Bejaine/Wake-Word-Detection-System-EW2/readme.md

## Wake Word Detection System
MEMS Microphone Pre-Amplifier with Automatic Gain Control (AGC) and Anti-Aliasing Filter for always-on voice wake-word detection in smart home devices. \
The hardware interface is created with all analog devices and the software component is a speech detection ML Model running on an edge device, the Raspberry Pi 4, API calling Gemini Flash for queries. \
[Link for the analog circit demonstration and wakeword demonstration](https://iiithydstudents-my.sharepoint.com/:f:/g/personal/bejaine_birju_students_iiit_ac_in/IgAevIl6izAORrplVr_9wEUuAbm-aCxeJ9gKoqiDplkEUGc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) \
Created as part of a project in the course Electronics Workshop 2 at IIIT Hyderabad.
