Bejaine/Wake-Word-Detection-System-EW2/Presentations/FinalEval-Presentation.pdf

## Electronics Workshop 2 - 2026

Course Project 2

Electronics Workshop 2 - 2026 | 1 / 24

## Team Details

Team - Table 10 Lab Nilgiri 114

Name: Ahamed Adikool Nishan Roll Number: 2024112025

Name: Bejaine Birju
Roll Number: 2024102060

## Project

Create a MEMS microphone preamplifier with automatic gain control (AGC) and anti-aliasing filter for always-on voice wake-word detection in smart home devices.

## Proposed Solution

A low power circuit using a preamplifier circuit along with the MEMS microphone interface, succeeded by an automatic gain control (AGC) stage, a gain circuit, an Anti Aliasing Filter and an Active Band Pass Filter, connected to an ADC and the ESP, interfaced with a Language Model aboard a Raspberry Pi 4 for wake word identification and querying.

## Stages

Stage 1: MEMS Interface
Stage 2: Pre-Amp Stage
Stage 3: Automatic Gain Control Stage 4: Gain Stage
Stage 5: Anti-Aliasing Filter Stage 6: Active Band Pass Filter Stage 7: ADC
Stage 8: ESP32
Stage 9: Raspberry Pi & TinyML model

## Stage 1: MEMS Interface

Component: SPW2430 MEMS Microphone & Breakout Board

Detects acoustic pressure and converts it to an analog voltage signal Small form factor, high sensitivity – ideal for voice recognition Requires 3.3 V DC at Vin; AC-coupled output fed to Pre-Amp Typical maximum output: ≈ 100 mVpp

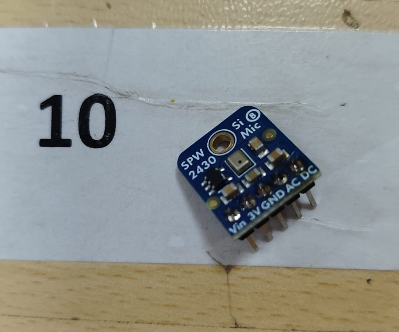
[picture p1: figure]

Figure: SPW2430 MEMS Microphone Module

## Stage 2: Pre-Amplifier – Theory

Topology: Common-Emitter Differential Amplifier (NPN BJT pair)

High input impedance, low output impedance, good noise rejection Amplifies differential signal; rejects common-mode noise (CMRR)

Single Input, Unbalanced Output configuration used

Key gain expressions:

Ad = −

gmRC
2

, Ac = −

αRC
re + 2REE

CMRR = 20 log
Ad
Ac
| ≈ 20 log(gmREE )

Design target: Single-ended differential gain Ad ≈ 10

## Stage 2: Pre-Amplifier – Design

Component values:
RC = 1.5 kΩ (collector load) REE = 3.3 kΩ (tail resistor, −5 V rail)
BJT: BC547B (β = 200)

Operating point:

IC ≈ 0.65 mA, | gm ≈ 26 mA/V
Ad ≈ 19.5, | Ac ≈ 0.23

CMRR ≈ 38.7 dB

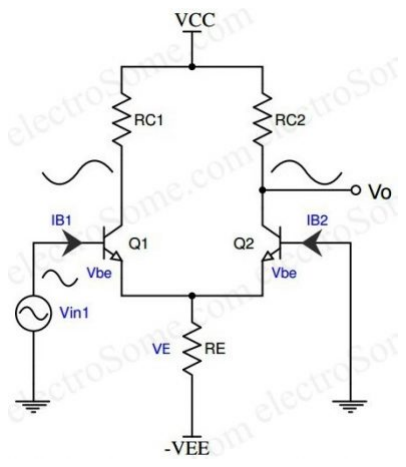
[picture p2: figure]

Figure: Pre-Amp Circuit Diagram

## Stage 3: Automatic Gain Control (AGC)

Components:
BF245B N-Channel JFET – Variable gain element UA741 Op-Amp – Inverting amplifier

BC557C PNP BJT – Envelope detector
R4 = 100 kΩ, R17 = 10 kΩ, C2 = 10 µF, R5 = 156 kΩ

Three functional blocks:
1 | Variable Gain Amplifier – JFET as gate-controlled resistor
2 | Envelope Detector – BC557C tracks signal peak into C2
3 | Control Feedback – VC drives JFET gate (negative feedback)

## AGC Theory: Variable Gain & Feedback

JFET channel resistance (ohmic region):

rDS (VGS ) = | rDS0
1 − VGS /VP

, rDS0 = 250 Ω, VP ≈ −2 V

Inverting amplifier gain:

Av (VGS ) = −

R4

R17 + rDS (VGS )

= −

100 k
10 k + rDS

Range: 0 to ≈ −9.76 (0 to ≈ 19.8 dB)

AGC time constants:

τattack ≪ 1 ms, τrelease = R5 · C2 = 156 kΩ × 10 µF = 1.56 s

Slow release prevents “pumping” artefacts during speech pauses.

Output coupling: fc = 1/(2π · 4.7 k · 1 µ) ≈ 33.9 Hz

## AGC LTspice Simulation Circuit

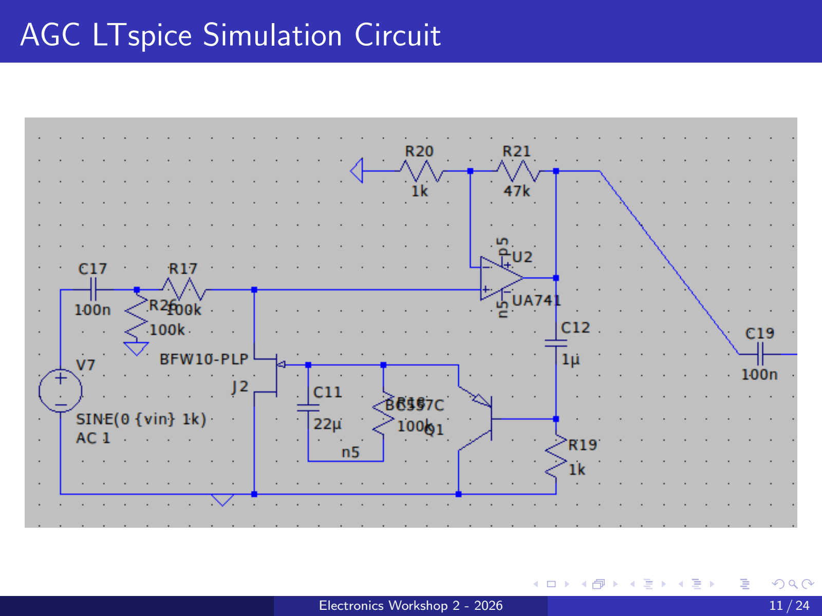
[picture p3: page 11]

## Stage 4: Gain Stage – Theory & Design

Topology: Common-Emitter amplifier with voltage-divider bias and split emitter resistors along with emitter degeneration.
We have designed for a voltage gain of 2.
The voltage gain ]

## Stage 5: Anti-Aliasing Filter (AAF) – Theory

Purpose: Low-pass filter before ADC to prevent aliasing (Nyquist–Shannon theorem)

Topology: 4th-order Butterworth – two cascaded 2nd-order Sallen-Key stages
Maximally flat passband – minimal distortion over voice band Rolloff: −80 dB/decade beyond cutoff
Cutoff set to 10 kHz (half the 20 kHz sampling rate)

Sallen-Key transfer function:

H(s) = | 1
s

2R1R2C1C2 + sC2(R1 + R2) + 1

ωc =

1
√
R1R2C1C2

, Q =

√
R1R2C1C2

C2(R1 + R2)

## AAF LTspice Simulation Circuit

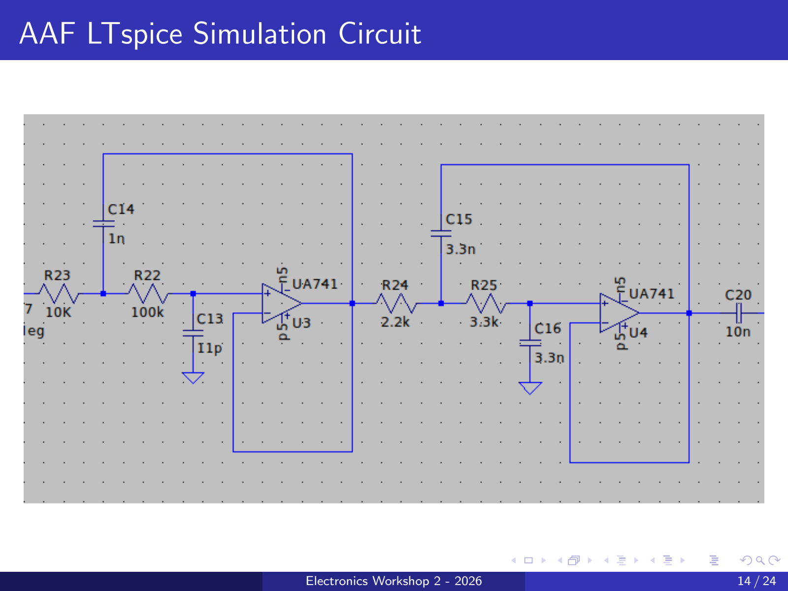
[picture p4: page 14]

## AAF Hardware Circuit

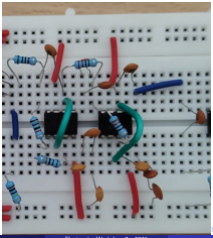
[picture p5: figure]

## Stage 6: Active Band Pass Filter – Theory

Purpose: Provide high-pass filtering (DC blocking) and additional low-pass filtering with amplification in a single stage.

Topology: Passive HPF → Non-inverting Op-Amp → Passive LPF

Overall transfer function:

H(s) =
1 + R4
R3
·

sR1C1
(1 + sR1C1)(1 + sR2C2)

Designed cutoffs:

fHP =

1
2π · 56 k · 47 n

≈ 60.5 Hz

fLP =

1
2π · 10 k · 2 n

≈ 7.96 kHz

Amplifier gain:

Av = 1 + 10 k
10 k = 2

## BPF LTspice Simulation Circuit

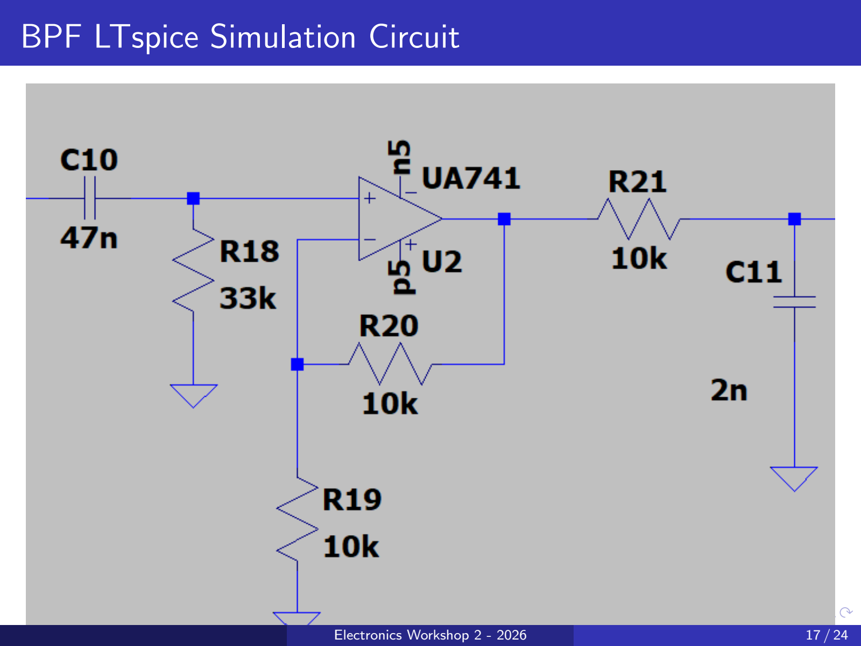
[picture p6: page 17]

## Input Protection: Schottky Diode Clamp (BAT54S)

Purpose: Protect ESP32 ADC from voltages outside 0–3.3 V

Topology: Rail-to-rail clamp (VF ≈ 0.25 V for BAT54S)

Vhigh = 3.3 + 0.25 = 3.55V, Vlow = 0 − 0.25 = −0.25V

Both within the ESP32 absolute maximum of 3.6 V.

In normal operation both diodes are reverse-biased and do not affect the signal. A standard silicon diode (VF ≈ 0.65 V) would clamp at 3.95 V – above the limit.

## Stage 7: Analog-to-Digital Converter (PCM1808)

Component: PCM1808 Stereo ADC (Texas Instruments)

Single-ended analog input, supports sample rates up to 96 kHz Operates in slave mode – I²S master clock provided by ESP32 System clock: 256fS , 384fS , or 512fS (auto-detected)
24-bit audio data, left-justified within 32-bit I²S frame

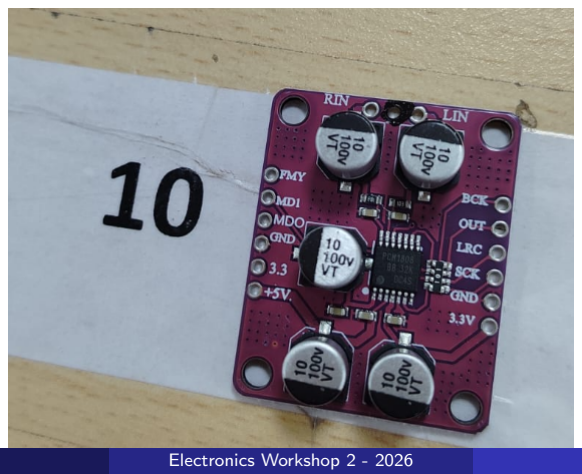
[picture p7: figure]

## Stage 8: ESP32 – I²S Master & Serial Bridge

Role: Drive the PCM1808 ADC and stream audio to Raspberry Pi over UART

I

2S configured at 16 kHz, 32-bit samples, mono (right channel)

APLL enabled for low-jitter master clock on GPIO 3 (MCLK) BCK / LRCK / DATA on GPIOs 26 / 25 / 22
Each 32-bit sample right-shifted by 16 bits → 16-bit PCM Framed UART transmission at 460800 baud: 4-byte sync header: 0xDE 0xAD 0xBE 0xEF
256 bytes audio payload (128 samples × 2 bytes)
8 DMA buffers × 512 bytes to prevent data loss

## Stage 9: Raspberry Pi 4 – Wake Word Detection

Role: Host processor running the full wake-word pipeline

1 | Frame Sync: Scan byte stream for 0xDE 0xAD 0xBE 0xEF header
2 | DSP Chain: 4th-order Butterworth BPF: 80–7500 Hz (SOS, 64-bit float) Linear gain 5×, hard-clipped to 16-bit range
3 | Wake-Word Inference:
| openWakeWord engine, pre-trained Alexa model Input: 1280 samples (80 ms at 16 kHz) Detection threshold: 0.1; debounce: 1.5 s

Final circuit demonstrated wake word detection with decent confidence scores in both noisy and non-noisy environments.

## Amazon Alexa!

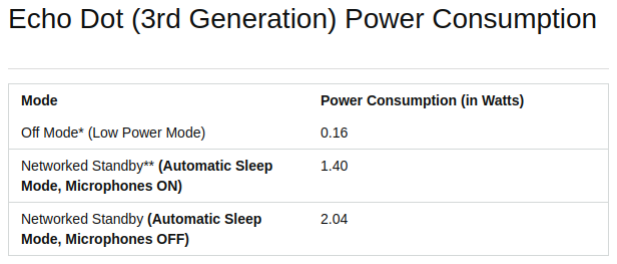
[picture p8: figure]

Figure: Power consumption metrics of the Amazon Alexa/Echo model with voice wake word detection Click here (https://www.amazon.co.uk/gp/help/customer/display.html?nodeId=GWYHKH4C79ZW6QPC)

## Our Alexa!

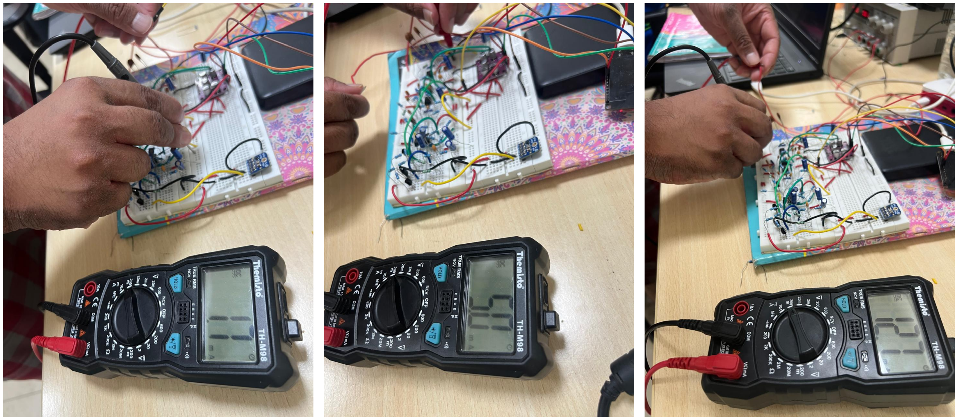
[picture p9: figure]

Figure: Pictures taken while measuring power consumed by our circuit

Ptotal = (3.3 V × 1.7 mA) + (5 V × 12.7 mA) + (5 V × 5 mA)

Ptotal = 5.61 mW + 63.5 mW + 25 mW = 94.11 mW

## Conclusion

Successfully designed and implemented a complete analog front-end for always-on wake word detection
Signal chain: MEMS mic → Pre-Amp → AGC → Gain → AAF → BPF → ADC → ESP32 → Raspberry Pi

AGC maintains constant output across varying speaker distances 4th-order Butterworth AAF provides −80 dB/decade attenuation Total power consumption: 94.11 mW (comparable to commercial devices)

Wake word “Alexa” detected with good confidence in noisy and quiet environments
