Bejaine/Wake-Word-Detection-System-EW2/Presentations/MidEval-Presentation.pdf

## Electronics Workshop 2 - 2026

Course Project 2

Electronics Workshop 2 - 2026 | 1 / 31

## Team Details

Team - Table 10 Lab Nilgiri 114

Name: Ahamed Adikool Nishan Roll Number: 2024112025

Name: Bejaine Birju
Roll Number: 2024102060

## Project

Create a MEMS microphone preamplifier with automatic gain control (AGC) and anti-aliasing filter for always-on voice wake-word detection in smart home devices.

## Proposed Solution

A low power circuit using a preamplifier circuit along with the MEMS microphone interface, succeeded by an automatic gain control (AGC) stage, a gain circuit, an anti-aliasing filter and a Schottky diode clamp for voltage regulation, interfaced with a Language Model for wake word identification.

## Stages

Stage 1: MEMS Interface
Stage 2: Pre-Amp Stage
Stage 3: Automatic Gain Control Stage 4: Gain Stage
Stage 5: Anti-Aliasing Filter Stage 6: Schottky Diode Clamp Stage 7: Large Language Model

## Components Needed

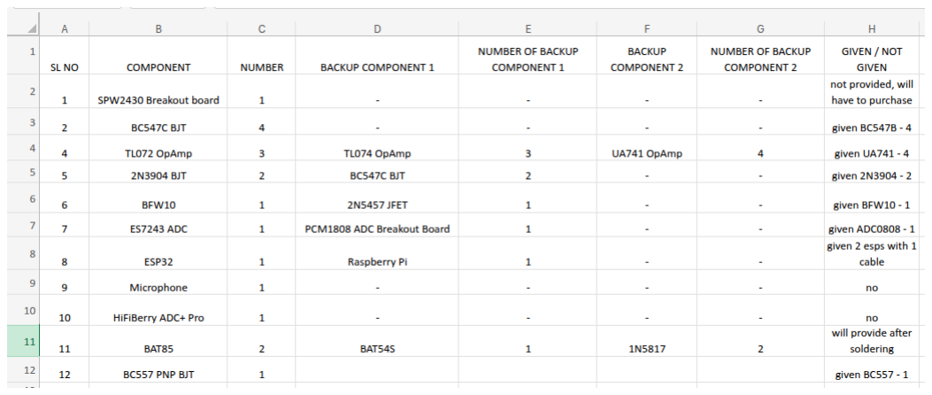
[picture p10: figure]

## Stage 1: MEMS Interface

Component: SPW2430 MEMS Microphone & Breakout Board

Note: The MEMS microphone module has not yet been received. The pre-amplifier stage is designed specifically to interface with the SPW2430 and will be finalised once the component is available.

## Stage 2: Pre Amplifier

Status: Pending MEMS module delivery.

The pre-amplifier topology and component values are dependent on the SPW2430 output impedance and bias voltage. Design will proceed once the MEMS breakout board is received and characterised.

## Stage 3: Automatic Gain Control (AGC)

Components:
BFW10 N-Channel JFET – 1
UA741 Op-Amp – 1

BC557C PNP BJT – 1

Resistors
Capacitors

## AGC Theory: Operating Principle

Goal: Keep output amplitude constant regardless of input level.

Three functional blocks:

1 | Variable attenuator – BFW10 JFET as a gate-controlled resistor
2 | Envelope detector – BC557C PNP BJT tracks the signal peak
3 | Error integrator – UA741 drives the JFET gate to regulate level

Feedback sense:
| Large input ⇒ BJT conducts more ⇒ gate driven negative
| More negative VGS ⇒ higher rDS ⇒ signal attenuated
| Loop settles when output equals the set-point

## AGC Theory: JFET Attenuator (BFW10)

BFW10 biased in the ohmic region so rDS varies with VGS :

rDS (VGS ) =

rDS(on)
1 − VGS /VP

rDS(on) ≈ 300 Ω, VP ≈ −6 V

Attenuator with R4 (100 kΩ):

Av =

rDS
R4 + rDS

=

rDS
100 kΩ + rDS

VGS = 0: rDS ≈ 300 Ω ⇒ Av ≈ 0.003
VGS → VP: rDS → ∞ ⇒ Av → 1

R9 (100 kΩ): High-impedance gate return resistor.

## AGC Theory: Input Network

C7 (100 nF) – Input coupling capacitor High-pass corner with R9∥R4:

Rload =

100 k × 100 k
200 k = 50 kΩ

fc =

1 2π · 100 nF · 50 kΩ | ≈ 31.8 Hz

Well below 1 kHz – effective across the full audio band.

R9 & R4 (100 kΩ each) – Signal divider
Form a 1:1 voltage divider to the JFET gate at quiescent conditions.

## AGC Theory: Envelope Detector (BC557C)

PNP BJT as a half-wave peak detector:

Emitter at JFET drain, base returned to ground via R5 Positive peaks forward-bias the emitter-base junction Collector current charges C2 to the signal peak amplitude

R5 (100 kΩ): Holds base at GND. BJT fires when VEB ≥ 0.6 V.

C2 (22 µF) – Envelope hold

τhold = R5 × C2 = 100 kΩ × 22 µF = 2.2 s

Long time constant prevents gain pumping on syllables.

## AGC Theory: Error Integrator (UA741)

Non-inverting error amplifier:
(+) input: envelope from BC557C
(−) input: GND (amplitude set-point)

Output: drives JFET gate via R9

Closed-loop gain:

ACL = 1 + R8
R7

= 1 + 47 kΩ
1 kΩ = 48

C3 (1 µF) – Loop stability

floop =

1
2π · R8 · C3

=

1
2π × 47 kΩ × 1 µF

≈ 3.4 Hz

Slow enough to ignore 1 kHz audio; fast enough to track speaker distance changes.

## AGC Theory: Output Stage & Signal Flow

R6 (1 kΩ) – Output load

Vout = ID × R6

Low output impedance drives the next stage without loading effects.

Signal and feedback paths:

Vin

C7, R9
−−−−→ gate

rDS (VGS )
−−−−−→ drain R6
−→ Vout

Vout

BC557C
−−−−−→ C2

UA741
−−−−→ VGS (negative feedback)

## AGC Theory: Component Summary

Component | Value | Role | Key Parameter
C7 | 100 nF | Input coupling | fc = 31.8 Hz
R9 | 100 kΩ | Gate bias/divider | High-Z gate path
R4 | 100 kΩ | Series attenuator | Divider with rDS
J1 (BFW10) | N-JFET | Variable resistor | rDS : 300 Ω → ∞
R5 | 100 kΩ | Base return | τ = 2.2 s with C2
C2 | 22 µF | Envelope hold | Ripple suppression
Q2 (BC557C) | PNP BJT | Envelope detector | VEB = 0.6 V
R7 | 1 kΩ | Gain (lower) | ACL = 48
R8 | 47 kΩ | Gain (upper) | floop = 3.4 Hz
C3 | 1 µF | Loop filter | Stability
R6 | 1 kΩ | Output load | Low Zout

## AGC LTspice Simulation Circuit

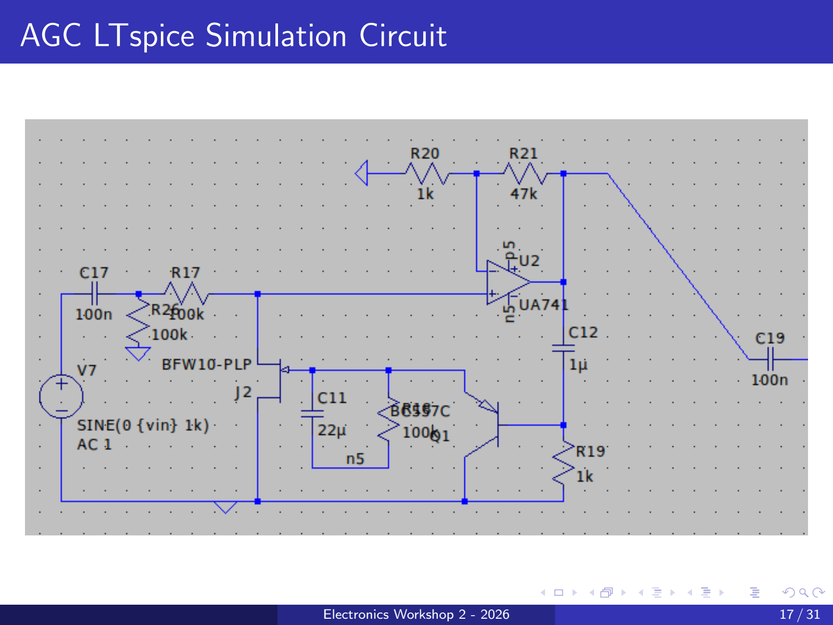
[picture p11: page 17]

## Stage 4: Gain Circuit

Topology: Common-Emitter (CE) amplifier with voltage-divider bias and split emitter resistors for stability.

Components:
G NPN1 (BC547B) NPN BJT – 1
G RB2 = 660 kΩ, G RB1 = 360 kΩ (bias divider) G RC1 = 2.2 kΩ (collector load)
G ree1 = 827 Ω (unbypassed emitter – stability)
G RE1 = 680 Ω + G CE1 = 4.2 µF (bypassed emitter)
C9 = 143 nF (input coupling), C8 = 13 nF (output coupling) R11 = 1 MΩ (next-stage input impedance)

## Gain Theory: DC Bias Analysis

Voltage divider sets the base voltage (VCC = 5 V):

VB = VCC ·

GRB1

GRB1 + GRB2

= 5 ×

360 k
1020 k = 1.76V

VE = VB − VBE = 1.76 − 0.7 = 1.06V

IC ≈ IE =

VE

Gree1 + GRE1

=

1.06
827 + 680

= 0.70 mA

VC = VCC − IC · GRC1 = 5 − 0.70 m × 2.2 k = 3.46 V

Collector sits close to mid-rail – good headroom for symmetric signal swing.

## Gain Theory: Small-Signal Parameters

From the DC operating point (IC = 0.70 mA, β = 200 for BC547B):

gm =

IC
VT

=

0.70 mA
26 mV = 26.9 mA/V

rπ =

β
gm

=

200
26.9 mA/V = 7.43 kΩ

Why split the emitter resistor?
G RE1 (680 Ω) is bypassed by G CE1 – contributes DC stability without reducing AC gain
G ree1 (827 Ω) remains unbypassed – provides AC negative feedback to stabilise gain against β variation and temperature

## Gain Theory: AC Voltage Gain

G CE1 short-circuits G RE1 at signal frequencies. Only G ree1 remains in the emitter at AC.

Effective collector load (G RC1 in parallel with R11):

RL = GRC1∥R11 = 2.2 k × 1 M 2.2 k + 1 M

≈ 2.195 kΩ

AC voltage gain:

Av =

−RL

Gree1 + 1/gm

=

−2195
827 + 37.2

=

−2195
864.2

≈ −2.54

Negative sign confirms phase inversion (standard CE behaviour).
Magnitude: |Av | ≈ 2.54 (≈ 8.1 dB).

## Gain Theory: Coupling & Bypass Capacitors

All high-pass corners must be well below the audio band (≪ 1 kHz).

C9 (143 nF) – Input coupling

fc,in =

1

2π · C9 · (GRB1∥GRB2∥rπ)

=

1
2π × 143 n × 6.3 k

≈ 176 Hz

C8 (13 nF) – Output coupling

fc,out =

1
2π · C8 · R11

=

1
2π × 13 n × 1 M

≈ 12.2 Hz

G CE1 (4.2 µF) – Emitter bypass

fc,byp =

1

2π · GCE1 · (Gree1 + 1/gm)

=

1
2π × 4.2 µ × 864

≈ 43.8 Hz

## Gain Theory: Component Summary

Component | Value | Role | Key Parameter
G RB2 | 660 kΩ | Upper bias resistor | VB = 1.76 V
G RB1 | 360 kΩ | Lower bias resistor | IC = 0.70 mA
G RC1 | 2.2 kΩ | Collector load | VC = 3.46 V
G ree1 | 827 Ω | Unbypassed emitter | Gain stabilisation
G RE1 | 680 Ω | Bypassed emitter | DC bias stability
G CE1 | 4.2 µF | Emitter bypass | fc = 43.8 Hz
C9 | 143 nF | Input coupling | fc = 176 Hz
C8 | 13 nF | Output coupling | fc = 12.2 Hz
R11 | 1 MΩ | Output load | High-Z next stage
gm = 26.9 mA/V | |Av | ≈ 2.54 (8.1 dB)

## Gain LTspice Simulation Circuit

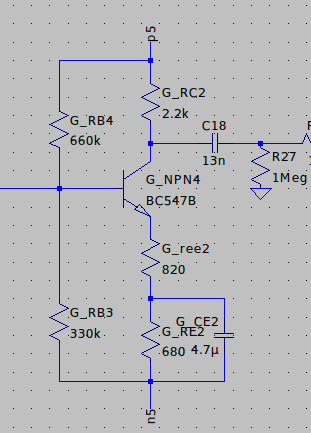
[picture p12: figure]

## Gain Hardware Circuit

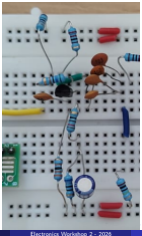
[picture p13: figure]

## Stage 5: Anti-Aliasing Filter (AAF)

Components:
HLF741 Op-Amp – 2

Resistors
Capacitors

## AAF Theory (1/2)

An anti-aliasing filter is effectively a low-pass filter that is placed on the input of an analog-digital converter (ADC). In theory, any type of active low-pass filter with unity gain can be used as an anti-aliasing filter. Any anti-aliasing filter design intends to remove high frequency content from the signal you want to sample with the goal of preventing aliasing. In this way, the goal in anti-aliasing filter design is to set the filter’s -3 dB cutoff frequency equal to half the sampling frequency.

## AAF Theory (2/2)

An anti-aliasing filter (AAF) is a low-pass filter used in signal processing to restrict the bandwidth of an analog signal before it is sampled by an Analog-to-Digital Converter (ADC). Its primary function is to ensure that the signal’s frequency content complies with the Nyquist-Shannon sampling theorem, which states that a signal can be perfectly reconstructed only if it is sampled at a rate (fs ) greater than twice its highest frequency component (fmax).
Without an AAF, any frequency components higher than half the sampling rate (the Nyquist frequency, fN =

fs
2

) will “alias” or fold back into the lower frequency spectrum. This creates artifacts and noise in the digital data that cannot be removed later because they become indistinguishable from the actual signal.
A high-quality AAF, such as a Butterworth filter, provides a maximally flat response in the passband to preserve signal integrity while offering steep attenuation in the stopband to eliminate these “ghost” frequencies.

## AAF LTspice Simulation Circuit

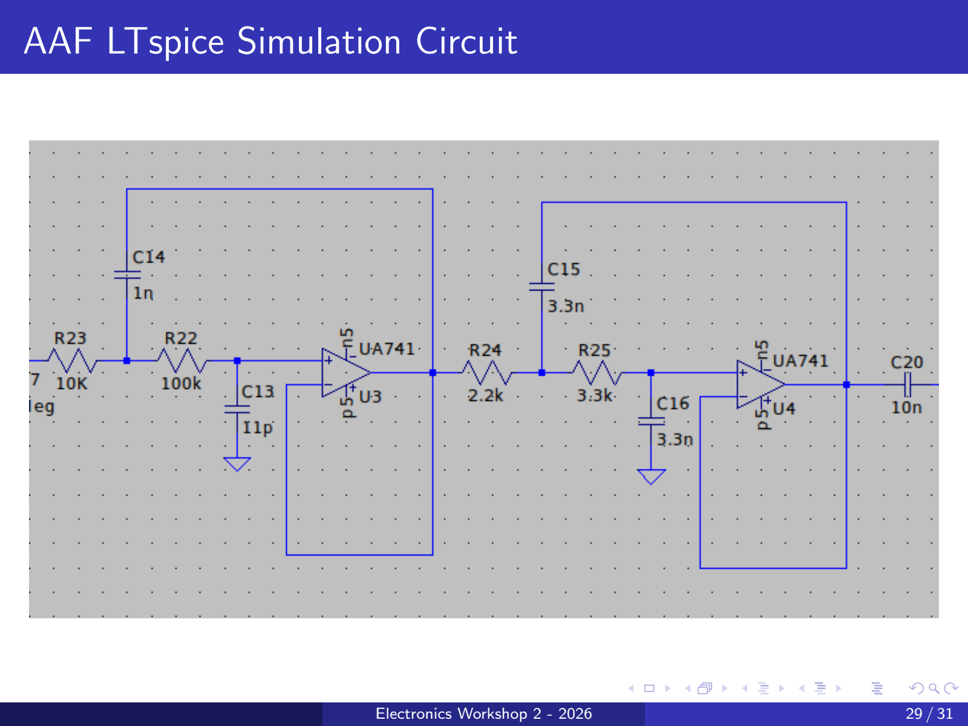
[picture p14: page 29]

## AAF Hardware Circuit


## Stage 6: Schottky Diode Clamp (BAT54S)

Purpose: Guard rail to protect the ESP32 ADC from voltages outside 0–3.3 V.

Topology: Two diodes in a rail-to-rail clamp:
D1: anode to signal, cathode to 3.3 V – clamps positive overshoots D2: anode to GND, cathode to signal – clamps negative swings

Clamp levels (BAT54S, VF ≈ 0.25 V):

Vhigh = 3.3 + 0.25 = 3.55V Vlow = 0 − 0.25 = −0.25V

Both within the ESP32 absolute maximum of 3.6 V. A standard silicon diode (VF ≈ 0.65 V) would clamp at 3.95 V – above the limit and therefore useless for protection. In normal operation both diodes are reverse-biased and do not affect the signal.
