Bejaine/Wake-Word-Detection-System-EW2/LTspice/AAF.asc

C1: cap; 110p
C4: cap; 1n
C5: cap; 5n
C6: cap; 3.3n
R1: res; 56k
R2: res; 10k
R3: res; 2200
R10: res; 2.2k
U8: opamp2; UA741
U9: opamp2; UA741
V2: voltage; 5
V3: voltage; -5
Named nets: 0, p5, n5
.lib C:\\Users\\Nishan\\Documents\\College\\2-2\\EW2\\Project2\\LTSPICE_model_files\\standard.jft
.inc C:\\Users\\Nishan\\Documents\\College\\2-2\\EW2\\Project2\\LTSPICE_model_files\\UA741.lib
