Bejaine/Wake-Word-Detection-System-EW2/LTspice/AGC.asc

C2: cap; 10µ
C3: cap; 1µ
C7: cap; 100n
J1: njf; BF245B-PLP
Q2: pnp; BC557C
R4: res; 100k
R5: res; 156k
R6: res; 4.7k
R7: res; 680
R8: res; 22k
R9: res; 100k
R17: res; 10k
U1: opamp2; UA741
V2: voltage; 5
V3: voltage; -5
Named nets: 0, n5, p5
.lib C:\\Users\\Nishan\\Documents\\College\\2-2\\EW2\\Project2\\LTSPICE_model_files\\standard.jft
.inc C:\\Users\\Nishan\\Documents\\College\\2-2\\EW2\\Project2\\LTSPICE_model_files\\UA741.lib
.SUBCKT BAT85 1 2
*
* The resistor R1 does not reflect
* a physical device. Instead it
* improves modeling in the reverse
* mode of operation.
*
D1 1 2 BAT85
R1 1 2 5.416E+7 
* 
.MODEL BAT85 D 
+ IS = 2.076E-7 
+ N = 1.023 
+ BV = 33 
+ IBV = 10E-6 
+ RS = 2.326 
+ CJO = 1.21E-11 
+ VJ = 0.1319 
+ M = 0.2904 
+ EG = 0.69 
+ XTI = 2 
.ENDS
