Bejaine/Wake-Word-Detection-System-EW2/LTspice/BPF.asc

C10: cap; 47n
C11: cap; 2n
R18: res; 56k
R19: res; 10k
R20: res; 10k
R21: res; 10k
U2: opamp2; UA741
V2: voltage; 5
V3: voltage; -5
Named nets: p5, n5, 0
.lib C:\\Users\\Nishan\\Documents\\College\\2-2\\EW2\\Project2\\LTSPICE_model_files\\standard.jft
.inc C:\\Users\\Nishan\\Documents\\College\\2-2\\EW2\\Project2\\LTSPICE_model_files\\UA741.lib
