Bejaine/Wake-Word-Detection-System-EW2/LTspice/Full-Circuit.asc

C1: cap; 110p
C2: cap; 10µ
C3: cap; 1µ
C4: cap; 1n
C5: cap; 5n
C6: cap; 3.3n
C7: cap; 100n
C8: cap; 13n
C9: cap; 10n
C10: cap; 47n
C11: cap; 2n
C12: cap; 10µ
G_CE1: cap; 4.7µ
G_NPN1: npn; BC547B
G_NPN2: npn; BC547B
G_NPN3: npn; BC547B
G_RB1: res; 1Meg
G_RB2: res; 660k
G_RC1: res; 1.82k
G_RE1: res; 680
G_ree1: res; 820
J1: njf; BF245B-PLP
Q2: pnp; BC557C
R1: res; 56k
R2: res; 10k
R3: res; 2200
R4: res; 100k
R5: res; 156k
R6: res; 4.7k
R7: res; 680
R8: res; 22k
R9: res; 100k
R10: res; 2.2k
R11: res; 1Meg
R12: res; 10110
R14: res; 0.98k
R15: res; 7.87k
R16: res; 7.85k
R17: res; 10k
R18: res; 56k
R19: res; 10k
R20: res; 10k
R21: res; 10k
R30: res; 0.99k
RG: res; 6.8k
U1: opamp2; UA741
U2: opamp2; UA741
U8: opamp2; UA741
U9: opamp2; UA741
V2: voltage; 5
V3: voltage; -5
V4: voltage; SINE(0 50m 1k); AC 1
Named nets: 0, n5, p5, out
.lib C:\\Users\\Nishan\\Documents\\College\\2-2\\EW2\\Project2\\LTSPICE_model_files\\standard.jft
.inc C:\\Users\\Nishan\\Documents\\College\\2-2\\EW2\\Project2\\LTSPICE_model_files\\UA741.lib
.tran 50m
.ac dec 50 1 10000000
.step param fin 1k 17k 2k
.SUBCKT BAT85 1 2
*
* The resistor R1 does not reflect
* a physical device. Instead it
* improves modeling in the reverse
* mode of operation.
*
D1 1 2 BAT85
R1 1 2 5.416E+7 
* 
.MODEL BAT85 D 
+ IS = 2.076E-7 
+ N = 1.023 
+ BV = 33 
+ IBV = 10E-6 
+ RS = 2.326 
+ CJO = 1.21E-11 
+ VJ = 0.1319 
+ M = 0.2904 
+ EG = 0.69 
+ XTI = 2 
.ENDS
.step param vin 0.05 0.5 0.05
.param t_s=100m
V=min(1.0,0.01+{V_step}*floor(time/{t_s}))*(sin(2*pi*1k*time))
.param V_step=0.05
