Bejaine/Wake-Word-Detection-System-EW2/LTspice/Gain.asc

C8: cap; 13n
C9: cap; 10n
G_CE1: cap; 4.7µ
G_NPN1: npn; BC547B
G_RB1: res; 1Meg
G_RB2: res; 660k
G_RC1: res; 1.82k
G_RE1: res; 680
G_ree1: res; 820
R11: res; 1Meg
V2: voltage; 5
V3: voltage; -5
Named nets: 0, p5, n5
.lib C:\\Users\\Nishan\\Documents\\College\\2-2\\EW2\\Project2\\LTSPICE_model_files\\standard.jft
.inc C:\\Users\\Nishan\\Documents\\College\\2-2\\EW2\\Project2\\LTSPICE_model_files\\UA741.lib
