Bejaine/Wake-Word-Detection-System-EW2/LTspice/PreAmp.asc

G_NPN2: npn; BC547B
G_NPN3: npn; BC547B
R14: res; 0.98k
R15: res; 7.87k
R16: res; 7.85k
R30: res; 0.99k
RG: res; 6.8k
V2: voltage; 5
V3: voltage; -5
Named nets: 0, p5, n5
.lib C:\\Users\\Nishan\\Documents\\College\\2-2\\EW2\\Project2\\LTSPICE_model_files\\standard.jft
.inc C:\\Users\\Nishan\\Documents\\College\\2-2\\EW2\\Project2\\LTSPICE_model_files\\UA741.lib
