Bejaine/Wake-Word-Detection-System-EW2/(commit log)

2026-05-06 changed few bugs in code and put esp code in required folder
    [api_call.py, esp32_test.ino, raw_wake.py]
2026-05-25 added LTspice circuit files
